kontikiki/LiftTruck_IoT/schematic.png

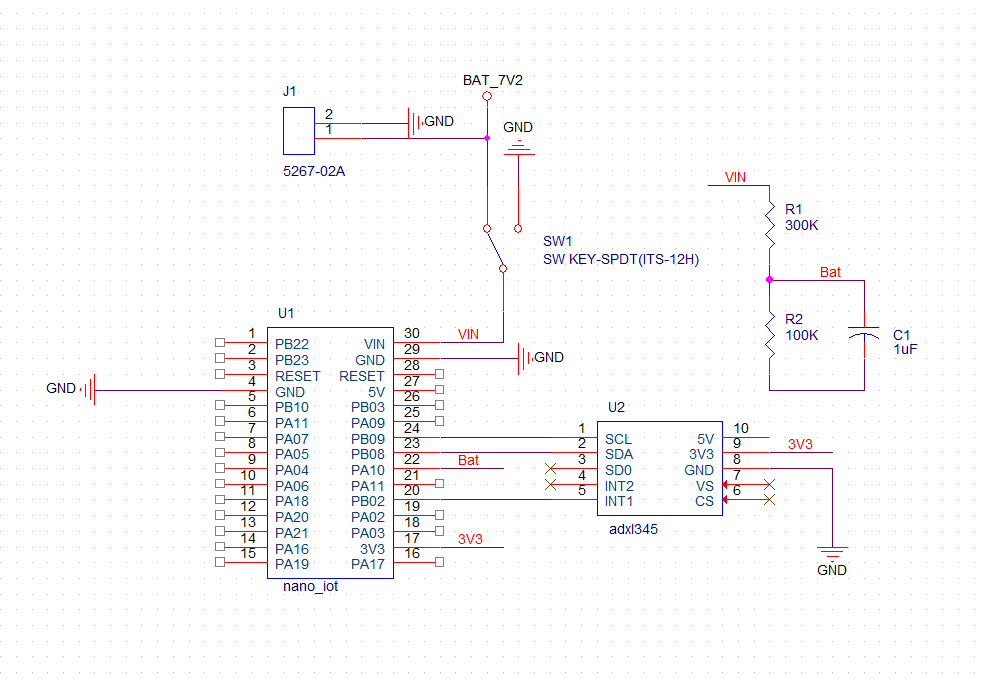
schematic.png
