kontikiki/LiftTruck_IoT/3d model/upper.stl

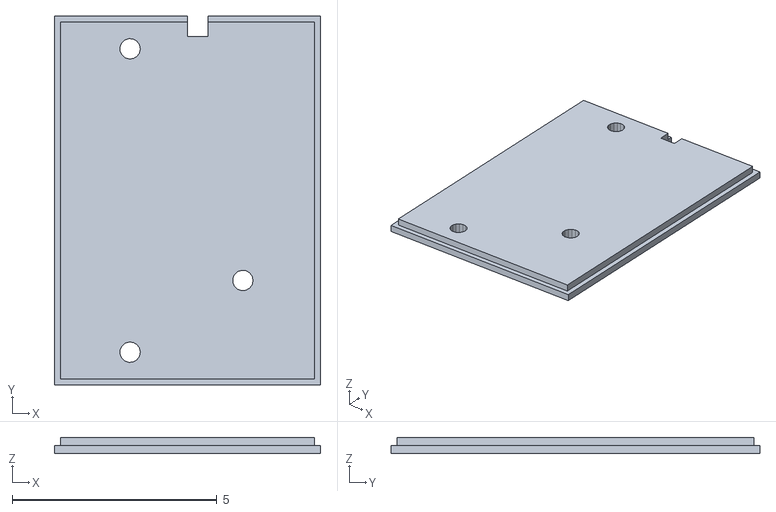
[picture p2: CAD file, 2020-04-03]
3d model/upper.stl
6.50 x 9.00 x 0.4
