kontikiki/LiftTruck_IoT/3d model/case.stl

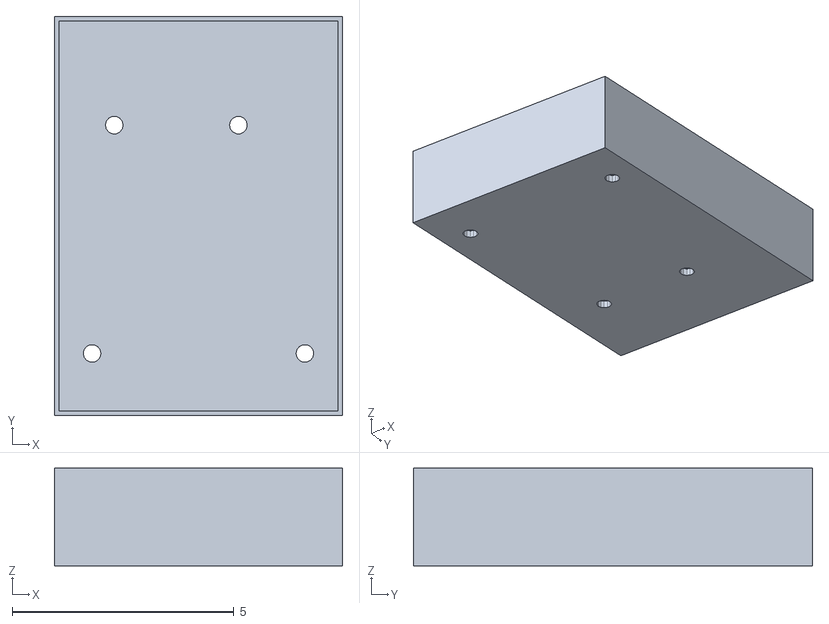
[picture p3: CAD file, 2020-04-03]
3d model/case.stl
6.50 x 9.00 x 2.20
