kontikiki/LiftTruck_IoT/(list of files, cad)

Other CAD files:
3d model/case.ipt
3d model/upper.ipt
