kontikiki/LiftTruck_IoT/rtc_adxl345_nano33_bleSerial_editEEPROM_aidsoft_v2/rtc_adxl345_nano33_bleSerial_editEEPROM_aidsoft_v2.ino

#include "WiFiNINA.h"
#include "WiFiUdp.h"
#include "Wire.h"
#include "ArduinoLowPower.h"
#include "SparkFun_ADXL345.h"
#include <math.h>
#include "FlashAsEEPROM_yn.h"
#include "AidSoft.h"
#include "secrets.h"
#include "ArduinoJson.h"

#define SERIAL_BAUDRATE 9600  //serial baud rate

#define SERVER_HOURS 00 //Server sending time(-debug-)
#define SERVER_MINUTES 15
#define SERVER_SECONDS 00

#define ALARM_TIMING 600000  //vehicle active mode measure-alarm timing(millis-debug-)

#define ACCEL_RANGE 4 //accelerometer range setting value
#define ACT_THRESHOLD 25  //accelerometer activity occur threshold
//accel data rate : 3200 ~ 0.098 our target rate is 100,50,25,12.5,6.25,3.125,1.563
#define ACCEL_RATE 100  //accelerometer data rate setting value
#define SAMPLING_NUM 10.0 // number of sampling
#define MEASURING_NUM 100 //measuring num per one sample
#define ACCEL_DELAY 10 //measurement sampling timing for 100 Hz
#define SPL_PERIOD    10  
#define SVM_BUFSIZE   (SPL_PERIOD*1) // buffer for calculation of accel avg sample
#define DEFINE_ACCEL 5.0  //active alarm mode condition

#define pin 15  //accel activity interrupt pin
#define BAT_PIN A3  //battery voltage measuring pin
#define VOLTAGE_FACTOR 4  //real value*4 = total battery value 
#define DEVICE_ID "A0003"

/*
   accelerometer
*/
// LSM6DS3Core myIMU(I2C_MODE,0x6B);
ADXL345 adxl = ADXL345();   //I2C
//ADXL345 adxl = ADXL345(3);  // SPI

typedef struct {
  float avg_acc;
  float acc_max;
} AccelData;

float base_accx, base_accy, base_accz;

void calibAccel();
void calculAccel(AccelData& accel);
float Calculate_std(float SVM_value);
void dataInit();
float SVM_buf[SVM_BUFSIZE];
float SVM_sum;
float SVM_avg; //The average value of STD values during the measurement time

//Buffer for calculating STD values
float STD_term[SVM_BUFSIZE];
float STD_term_sum;
float STD;
uint32_t spl_cnt;
uint32_t spl_time_cnt = 1;


/*
   Wifi connection & RTC
*/
char ssid[] = SECRET_SSID;
char pass[] = SECRET_PASS;
int keyIndex = 0;
WiFiClient client;
int status = WL_IDLE_STATUS;
unsigned long GMT = 9 * 60 * 60; //gap seconds between (seoul,South Korea) and GMT

void printWiFiStatus();
void resetEpoch();
void printEpoch();
void print2digits(int number);

/*
   Server
*/
const char * APIKey = SECRET_WRITE_APIKEY;

uint8_t number1 = 0;
uint8_t number2 = 0;
const char *number3 = DEVICE_ID;
String myStatus = ""; //for battery-state
String timeStamp = "";

void sendToServer(int number);
void sendVoltageStateToServer();
int readBattery();

/*
   for read & write data to flash
*/
char buf[128];

//instance for read & write packet to flash and number of written packet
EEPROMpacket EEPROMpkt;
EEPROMpacket writtenPacket[128];
int pkt_num;

void initFlash();
int readPacketFromFlash();
void writePacketToFlash();
//void packetMake(float acc_max, float avg_acc);
void packetMake(bool active);
void getHighActiveTime();

/*
   interrupt flag (time to sending data flag, accel activity occur flag, alarm mode(vehicle active-state) flag )
*/
volatile bool time_flag = false;  //24 o'clock RTC wake up interrupt flag (for sending data)
volatile bool accel_flag = false; //accelerometer activity-wake up interrupt flag
//volatile bool inact_flag = false;
volatile bool setActiveAlarm_flag = false;  //vehicle active-state flag


/***********************function definition ******************************/

/*
   for accelerometer calibration, calculation
*/
void dataInit()
{
  spl_cnt = 0;
  SVM_sum = 0;
  SVM_avg = 0;
  STD_term_sum = 0;

  for (int i = 0 ; i < SVM_BUFSIZE ; i++)
  {
    SVM_buf[i] = 0;
    STD_term[i] = 0;
  }
}

float Calculate_std(float SVM_value)
{
  float STD_value;

  SVM_sum = SVM_sum - SVM_buf[0];
  STD_term_sum = STD_term_sum - STD_term[0];

  /* data shift */
  for (int i = 1 ; i < SVM_BUFSIZE ; i++)
  {
    SVM_buf[i - 1] = SVM_buf[i];
    STD_term[i - 1] = STD_term[i];
  }
  SVM_buf[SVM_BUFSIZE - 1] = SVM_value;
  SVM_sum = SVM_sum + SVM_buf[SVM_BUFSIZE - 1];

  if (spl_cnt >= SVM_BUFSIZE) {
    SVM_avg = SVM_sum / SVM_BUFSIZE;
  } else {
    SVM_avg = SVM_sum / spl_cnt;
  }

  STD_term[SVM_BUFSIZE - 1] = pow((SVM_value - SVM_avg), 2.0);
  STD_term_sum = STD_term_sum + STD_term[SVM_BUFSIZE - 1];

  STD_value = (float)sqrt(STD_term_sum / SVM_BUFSIZE);

  return STD_value;
}

void calibAccel() {

  int x, y, z;
  int32_t sumAcX = 0, sumAcY = 0, sumAcZ = 0;
  adxl.setRate(ACCEL_RATE);
  delay(ACCEL_DELAY);
  for (int i = 0; i < 100; i++) {

    adxl.readAccel(&x, &y, &z);
    sumAcX += x;
    sumAcY += y;
    sumAcZ += z;
    digitalWrite(LED_BUILTIN, HIGH);
    delay(ACCEL_DELAY / 2);
    digitalWrite(LED_BUILTIN, LOW);
    delay(ACCEL_DELAY / 2);
  }

  base_accx = sumAcX / 10;
  base_accy = sumAcY / 10;
  base_accz = sumAcZ / 10;


  //  for debugging
  Serial.print("base_accx :");
  Serial.println(base_accx);
  Serial.print("base_accy :");
  Serial.println(base_accy);
  Serial.print("base_accz :");
  Serial.println(base_accz);
}

void calculAccel(AccelData& accel) {
 
  int x, y, z;
  float cal_x, cal_y, cal_z;

  float total_std = 0;
  float svm_acc = 0;
  float avg_std = 0;
  float std_max = 0;
  float temp_avg=0;
  float total_temp=0;
  
  for (int i = 0; i < SAMPLING_NUM ; i++) {
    dataInit();
    //100Hz sampling
    delay(ACCEL_DELAY);
    for (int i = 0; i < MEASURING_NUM; i++) {
      spl_cnt++;
      adxl.readAccel(&x, &y, &z);

      cal_x = (float)x - base_accx;
      cal_y = (float)y - base_accy;
      cal_z = (float)z - base_accz;

      svm_acc = sqrt(pow(cal_x, 2.0) + pow(cal_y, 2.0) + pow(cal_z, 2.0));
/*
      // Output Results to Serial
      Serial1.print(cal_x);
      Serial1.print(", ");
      Serial1.print(cal_y);
      Serial1.print(", ");
      Serial1.println(cal_z);
      Serial1.print("svm= ");
      Serial1.println(svm_acc);
*/
      STD = Calculate_std(svm_acc);

      if (STD > std_max) {
        std_max = STD;
      }
      total_std += STD;

      digitalWrite(LED_BUILTIN, HIGH);
      delay(ACCEL_DELAY / 2);
      digitalWrite(LED_BUILTIN, LOW);
      delay(ACCEL_DELAY / 2);
    }
    
    temp_avg=total_std /100;
    Serial.print("temp_avg_std=");
    Serial.println(temp_avg);
    total_temp+=temp_avg;
    total_std=0;
  }
    avg_std = total_temp / SAMPLING_NUM;

    Serial.println("------------------");
    Serial.print("avg_std =");
    Serial.println(avg_std);
    Serial.print("std_max=");
    Serial.println(std_max);
    Serial.println("------------------");
    accel.avg_acc = avg_std;
    accel.acc_max = std_max;
  }

  void sendVoltageStateToServer() {
    digitalWrite(LED_BUILTIN, HIGH);
    int x;
    int battery = readBattery();
    float voltage = ((float)map(battery, 0, 1024, 0, 33)) / 10.0;
    voltage=voltage*VOLTAGE_FACTOR;
    Serial.print(" battery voltage : ");
    Serial.println(voltage);
    sprintf(buf, "readValue : %d, battery voltage : %0.2f V", battery, voltage);
    myStatus = String(buf);

    connectServer();
    const int capacity = JSON_OBJECT_SIZE(2);
    StaticJsonDocument<capacity> JsonDoc;
    JsonDoc["status"] = myStatus.c_str();
    JsonDoc["field3"] = number3;
    int contentLength = measureJson(JsonDoc);
    serializeJson(JsonDoc, Serial);
    HTTPheader(contentLength, APIKey);
    serializeJson(JsonDoc, client);

    x = finishWrite();
    if (x == 200) {
      Serial.println("Channel update successful.");
    }
    else {
      Serial.print(" error code :");
      Serial.println(x);
      //  Serial1.println("Problem updating channel. HTTP error code ");
    }
    memset(buf, 0, sizeof(buf));
    delay(100);
    digitalWrite(LED_BUILTIN, LOW);
  }

  void sendToServer(int number) {
    int j, x, y;
    for (j = 0; j < number; j++) {
      digitalWrite(LED_BUILTIN, HIGH);
      //ex> "2017-01-12 13:22:54"
      sprintf(buf, "%d-%d-%d %d:%d:%d", 2000 + (writtenPacket[j].active_time.g_year), writtenPacket[j].active_time.g_month, writtenPacket[j].active_time.g_day, writtenPacket[j].active_time.g_hours, writtenPacket[j].active_time.g_minutes, writtenPacket[j].active_time.g_seconds);
      Serial.println(buf);
      timeStamp = String(buf);

      number1 = writtenPacket[j].active;
      number2 = writtenPacket[j].num;

      connectServer();
      const int capacity = JSON_OBJECT_SIZE(4);
      StaticJsonDocument<capacity> JsonDoc;
      JsonDoc["field1"] = number1;
      JsonDoc["field2"] = number2;
      JsonDoc["field3"] = number3;
      JsonDoc["created_at"] = timeStamp.c_str();
      int contentLength = measureJson(JsonDoc);
      serializeJson(JsonDoc, Serial);
      HTTPheader(contentLength, APIKey);
      serializeJson(JsonDoc, client);

      x = finishWrite();
      if (x == 200) {
        Serial.println("Channel update successful.");
      }
      else {
        Serial.print(" error code :");
        Serial.println(x);
        Serial.println("Problem updating channel. HTTP error code ");
      }
      Serial.println();
      memset(buf, 0, sizeof(buf));
      delay(100); //AidSoft update time gap
      digitalWrite(LED_BUILTIN, LOW);
    }
    Serial.println("all data are sent to AidSoft channel.");
  }

  //erase all written data in flash
  void initFlash() {
    EEPROM.isValid();
    EEPROM.commit();
    Serial.println("all data in flash was erased successly.");
    pkt_num = 0;
  }

  //read all written data from flash
  int readPacketFromFlash() {
    int i = 0;
    while (i < pkt_num) {
      writtenPacket[i] = EEPROM.read(i);

      Serial.print("read packet number: ");
      Serial.println(writtenPacket[i].num);
      sprintf(buf, "%d-%d-%d %d:%d:%d vehicle state :%d", 2000 + (writtenPacket[i].active_time.g_year), writtenPacket[i].active_time.g_month, writtenPacket[i].active_time.g_day, writtenPacket[i].active_time.g_hours, writtenPacket[i].active_time.g_minutes, writtenPacket[i].active_time.g_seconds, writtenPacket[i].active);
      Serial.println(buf);
      i++;
    }
    Serial.print(i);
    Serial.println(" packets in flash were Read Successly.");
    return i;
  }

  //write one data(acceleration & time) to flash
  void writePacketToFlash() {

    if (pkt_num > 127) {
      Serial.println("packet num is exceed range. restart 0-th packet.");
      pkt_num = 0;
    }
    EEPROM.convert(pkt_num, &EEPROMpkt);
    EEPROM.commit();
    Serial.println("Flash Writing Process Success.");
    pkt_num++;
  }

  //make data with packet time & accel data

  /*
    void packetMake(float acc_max, float avg_acc) {
    getHighActiveTime();
    Serial.println("------------------");
    EEPROMpkt.acc_max = acc_max;
    EEPROMpkt.avg_acc = avg_acc;
    EEPROMpkt.num = pkt_num;


    Serial.println("written packet data : ");
    Serial.println(EEPROMpkt.acc_max);
    Serial.println(EEPROMpkt.avg_acc);
    Serial.println(EEPROMpkt.num);
    Serial.println("============");
    Serial.println("Packet Make Success");
    }
  */
  void packetMake(bool active) {
    getHighActiveTime();
    Serial.println("------------------");
    EEPROMpkt.active = active;
    EEPROMpkt.num = pkt_num;
    Serial.println("written packet data : ");
    Serial.println(EEPROMpkt.active);
    Serial.println(EEPROMpkt.num);
    Serial.println("============");
    Serial.println("Packet Make Success");
  }

  //get present time
  void getHighActiveTime() {
    EEPROMpkt.active_time.g_day = (uint8_t)LowPower.rtc.getDay();
    EEPROMpkt.active_time.g_month = (uint8_t)LowPower.rtc.getMonth();
    EEPROMpkt.active_time.g_year = (uint8_t)LowPower.rtc.getYear();
    EEPROMpkt.active_time.g_hours = (uint8_t)LowPower.rtc.getHours();
    EEPROMpkt.active_time.g_minutes = (uint8_t)LowPower.rtc.getMinutes();
    EEPROMpkt.active_time.g_seconds = (uint8_t)LowPower.rtc.getSeconds();
    Serial.println("Timestamp Write Success");
  }

  int readBattery() {
    int readValue = analogRead(BAT_PIN);
    Serial.print("reading value is ");
    Serial.println(readValue);
    return readValue;
  }
  /*****************************setup()*********************************/
  void setup() {
    while (!Serial);
    Serial.begin(SERIAL_BAUDRATE);
    pinMode(pin, INPUT_PULLUP);
    pinMode(LED_BUILTIN, OUTPUT);
    pkt_num = 0;

    /*
      if (WiFi.status() == WL_NO_SHIELD) {
        Serial.println("WiFi shield not present");
        while (1);  //breakout
      }
    */
    while (status != WL_CONNECTED) {
      Serial.print("Attempting to connect to SSID: ");
      Serial.println(ssid);
      status = WiFi.begin(ssid, pass);
      delay(5000);
    }

    printWiFiStatus();

    LowPower.rtc.begin();

    resetEpoch(); //getting present time epoch

    WiFi.disconnect();
    WiFi.lowPowerMode();
    status = WL_IDLE_STATUS;

    LowPower.rtc.setAlarmTime(SERVER_HOURS,SERVER_MINUTES,SERVER_SECONDS);  //setting alarm time
    LowPower.rtc.enableAlarm(LowPower.rtc.MATCH_HHMMSS);
    LowPower.rtc.attachInterrupt(onTimeFlag);  //alarm interrupt wake up setting

    //accelerometer initial seqeunce timing value
    delayMicroseconds(1100);
    //accelerometer setting
    adxl.powerOn();
    //adxl.writeTo(ADXL345_POWER_CTL, 24);  //auto sleep mode, measure state
    //adxl.writeTo(0x2E,0x00); //enable DATA_READY Interrupt

    adxl.setRangeSetting(ACCEL_RANGE);  // range settings : Accepted values are 2g, 4g, 8g or 16g
    //  adxl.setRate(ACCEL_RATE);  // data rate setting : 1.563 Hz
    //adxl.setSpiBit(1);

    adxl.setActivityXYZ(1, 1, 1); // Set to activate movement detection in the axes "adxl.setActivityXYZ(X, Y, Z);" (1 == ON, 0 == OFF)
    adxl.setActivityThreshold(ACT_THRESHOLD);  // 62.5mg per increment   // Set activity   // activity thresholds (0-255)

    adxl.setInactivityXYZ(0, 0, 0);     // Set to detect inactivity in all the axes "adxl.setInactivityXYZ(X, Y, Z);" (1 == ON, 0 == OFF)

    adxl.setInactivityThreshold(75);    // 62.5mg per increment   // Set inactivity // Inactivity thresholds (0-255)
    adxl.setTimeInactivity(20);

    adxl.setTapDetectionOnXYZ(0, 0, 0);

    adxl.setInterruptLevelBit(1);   //set INT pin HIGH (active:low, non:high)
    //adxl.setInterruptMapping(ADXL345_INT_ACTIVITY_BIT, ADXL345_INT1_PIN);

    adxl.InactivityINT(0);
    adxl.ActivityINT(1);  //Turn on Interrupts for Activity mode(1 == ON, 0 == OFF)
    adxl.FreeFallINT(0);
    adxl.doubleTapINT(0);
    adxl.singleTapINT(0);

    calibAccel();
    delay(100);
    LowPower.attachInterruptWakeup(digitalPinToInterrupt(pin), onAccelFlag, FALLING);

    Serial.println("mcu is going to sleep.. ");
    Serial.println();

    delay(100);
      Serial.end();
    LowPower.sleep();
  }

  /**********************************loop()******************************/
  void loop() {
      Serial.begin(SERIAL_BAUDRATE);
      //while (!Serial);
    Serial.println("wake up!");

    //at 24 o'clock, sending data to server via AP
    if (time_flag) {
      Serial.println("onTime interrupt generated!");
      //    resetEpoch();
      time_flag = false;

    WiFi.noLowPowerMode();

    delay(500);
      while (status != WL_CONNECTED) {
      Serial.print("Attempting to connect to SSID: ");
      Serial.println(ssid);
      status = WiFi.begin(ssid, pass);
      delay(5000);
    }
  printWiFiStatus();
      sendVoltageStateToServer();
      if (pkt_num > 0) {
        int num = readPacketFromFlash();

        if (num == pkt_num) {
          Serial.println("all written packets were read from flash Successly.");
        }

        sendToServer(pkt_num);
        initFlash();
      }

    WiFi.disconnect();
    WiFi.lowPowerMode();
    status = WL_IDLE_STATUS;
    
      adxl.setActivityXYZ(1, 1, 1);
      adxl.ActivityINT(1);

      LowPower.attachInterruptWakeup(digitalPinToInterrupt(pin), onAccelFlag, FALLING);
    }

    //if activity interrupt signal occur from adxl345, accel_flag is true
    else if (accel_flag) {

      accel_flag = false;
      AccelData accel;
      calculAccel(accel);

      //Determine whether the average accel-value is higher or lower than the reference value,
      //if lower, go "just normal mode" : 24'o clock alarm setting and waiting for activity INT
      //if higher,go "active-alarm setting mode" : every 30 minutes wake-up setting, and estimate acceleration
      if (accel.avg_acc < DEFINE_ACCEL) {
        packetMake(0);
        writePacketToFlash();
     
        Serial.print(accel.avg_acc);
        Serial.print(" is < ");
        Serial.println(DEFINE_ACCEL);
        Serial.println("just normal mode.");

        LowPower.rtc.attachInterrupt(onTimeFlag);
        adxl.setActivityXYZ(1, 1, 1);
        adxl.ActivityINT(1);
        LowPower.attachInterruptWakeup(digitalPinToInterrupt(pin), onAccelFlag, FALLING);

      } else {
        packetMake(1);
        writePacketToFlash();
 
        Serial.print(accel.avg_acc);
        Serial.print(" is > ");
        Serial.println(DEFINE_ACCEL);
        Serial.print("Active ");
        Serial.print(ALARM_TIMING / 1000);
        Serial.println("sec alarm ON set");

        LowPower.rtc.disableAlarm();
        LowPower.setAlarmIn(ALARM_TIMING);
        LowPower.rtc.attachInterrupt(onHighFlag);
      }
    }//end of accel_flag

    //if vehicle is running mode, setActiveAlarm_flag is true
    else if (setActiveAlarm_flag) {

      setActiveAlarm_flag = false;

      AccelData accel;
      calculAccel(accel);

      if (accel.avg_acc > DEFINE_ACCEL) {
        packetMake(1);
        writePacketToFlash();

        Serial.print(accel.avg_acc);
        Serial.print(" is > ");
        Serial.println(DEFINE_ACCEL);
        Serial.print("and ");
        Serial.print(ALARM_TIMING / 1000);
        Serial.println("sec alarm is ON constantly.");

        LowPower.setAlarmIn(ALARM_TIMING);
        LowPower.rtc.attachInterrupt(onHighFlag);
      }
      else {
        packetMake(0);
        delay(100);
        writePacketToFlash();
        delay(100);

        Serial.print(accel.avg_acc);
        Serial.println(" is < ");
        Serial.println(DEFINE_ACCEL);
        Serial.println("Last written.");
        Serial.println("and alarm OFF set.");

        LowPower.rtc.detachInterrupt();
        LowPower.rtc.disableAlarm();
        LowPower.rtc.setAlarmTime(SERVER_HOURS,SERVER_MINUTES,SERVER_SECONDS);
        LowPower.rtc.enableAlarm(LowPower.rtc.MATCH_HHMMSS);

        delay(100);
        LowPower.rtc.attachInterrupt(onTimeFlag);
        adxl.setActivityXYZ(1, 1, 1);
        adxl.ActivityINT(1);
        LowPower.attachInterruptWakeup(digitalPinToInterrupt(pin), onAccelFlag, FALLING);
      }
    }//end of setActiveAlarm_flag
    Serial.println("mcu is going to sleep.. ");
    Serial.println();
    Serial.end();
    LowPower.sleep();
  }

  /************************Interrupt & Alarm ISR ****************************/

  void onHighFlag() {
    setActiveAlarm_flag = true;
  }

  void onTimeFlag() {
    time_flag = true;
    adxl.ActivityINT(0);
    adxl.setActivityXYZ(0, 0, 0);
    detachInterrupt(pin);
  }

  void onAccelFlag() {
    LowPower.rtc.detachInterrupt();
    adxl.ActivityINT(0);
    adxl.setActivityXYZ(0, 0, 0);
    detachInterrupt(pin);

    byte interrupts = adxl.getInterruptSource();
    if (adxl.triggered(interrupts, ADXL345_ACTIVITY)) {

      accel_flag = true;
    }
  }

  /************************ RTC getting WiFi epoch *************************/

  void resetEpoch() {
    unsigned long epoch;
    int numberOfTries = 0, maxTries = 10;
    do {
      epoch = WiFi.getTime();
      numberOfTries++;

      if (numberOfTries >= maxTries) {
        Serial.println("NTP unreachable!");
        numberOfTries = 0;
        delay(2000);
      }
    } while (epoch == 0);

    Serial.print("Epoch received : ");
    Serial.println(epoch);
    LowPower.rtc.setEpoch(epoch + GMT);
    //LowPower.rtc.setEpoch(epoch); //used in ThingSpeak
    printEpoch();
  }

  void print2digits(int number) {
    if (number < 10) {
      Serial.print("0"); // print a 0 before if the number is < than 10
    }
    Serial.print(number);
  }

  void printWiFiStatus() {
    Serial.print("SSID : ");
    Serial.println(WiFi.SSID());

    IPAddress ip = WiFi.localIP();
    Serial.print("IP Address : ");
    Serial.println(ip);

    long rssi = WiFi.RSSI();
    Serial.print("signal strength (RSSI) : ");
    Serial.print(rssi);
    Serial.println( "dBm");
  }

  void printEpoch() {
    Serial.println("-----------------");
    Serial.println("set WiFi RTC");
    print2digits(LowPower.rtc.getDay());
    Serial.print("/");
    print2digits(LowPower.rtc.getMonth());
    Serial.print("/");
    print2digits(LowPower.rtc.getYear());
    Serial.print(" ");
    // ...and time
    print2digits(LowPower.rtc.getHours());
    Serial.print(":");
    print2digits(LowPower.rtc.getMinutes());
    Serial.print(":");
    print2digits(LowPower.rtc.getSeconds());
    Serial.println();
  }
