kontikiki/LiftTruck_IoT/rtc_adxl345_nano33_20200309/rtc_adxl345_nano33_20200309.ino

#include <WiFiNINA.h>
#include <WiFiUdp.h>
//#include "SparkFunLSM6DS3.h"
#include "Wire.h"
#include <SPI.h>
//#include <time.h>
#include <ArduinoLowPower.h>
#include <SparkFun_ADXL345.h>
#include <math.h>
#include <FlashStorage.h>
#include <ThingSpeak.h>
#include "secrets.h"

#define DEFINE_ACCEL 20.0
int cnt=0;

char ssid[] = SECRET_SSID;
char pass[] = SECRET_PASS;
int keyIndex = 0;
WiFiClient client;

unsigned long myChannelNumber = SECRET_CH_ID;
const char * myWriteAPIKey = SECRET_WRITE_APIKEY;

// Initialize our values
float number1 = 0;
float number2 = 0;
int number3 = 0;

String myStatus = "";

int status = WL_IDLE_STATUS;

unsigned long GMT = 9 * 60 * 60; //gap seconds between (seoul,South Korea) and GMT
const int pin = 3;  //accelerometer activity-wake up interrupt generation pin

// LSM6DS3Core myIMU(I2C_MODE,0x6B);  //accelerometer
ADXL345 adxl = ADXL345();
//ADXL345 adxl = ADXL345(3);

volatile bool time_flag = false;  //24 o'clock RTC wake up interrupt flag (for sending data)
volatile bool accel_flag = false; //accelerometer activity-wake up interrupt flag
//volatile bool inact_flag = false;
volatile bool setActiveAlarm_flag = false;
char buf[64];

typedef struct timestamp {
  int g_day, g_month, g_year, g_hours, g_minutes, g_seconds;
}timestamp;

typedef struct EEPROMpacket {
  timestamp active_time;
  float svg_max;
  float avg_svg;
  int num;
}EEPROMpacket;

EEPROMpacket EEPROMpkt;
EEPROMpacket writtenPacket[48];
volatile int pkt_num;

Flash(accel_data_store, sizeof(EEPROMpacket));

float base_accx, base_accy, base_accz;

void sendThingSpeak(int number) {
  int j;
  for (j = 0; j < number; j++) {
    sprintf(buf, "%d/%d/%d/%d:%d:%d,max_svg: %f avg_svg: %f\n", writtenPacket[j].active_time.g_day, writtenPacket[j].active_time.g_month, writtenPacket[j].active_time.g_year, writtenPacket[j].active_time.g_hours, writtenPacket[j].active_time.g_minutes, writtenPacket[j].active_time.g_seconds, writtenPacket[j].svg_max, writtenPacket[j].avg_svg);
    Serial.println(buf);
    myStatus = String(buf);

    number1 = writtenPacket[j].svg_max;
    number2 = writtenPacket[j].avg_svg;
    number3 = writtenPacket[j].num;

    ThingSpeak.setField(1, number1);
    ThingSpeak.setField(2, number2);
    ThingSpeak.setField(3, number3);

    ThingSpeak.setStatus(myStatus);

    int x = ThingSpeak.writeFields(myChannelNumber, myWriteAPIKey);
    if (x == 200) {
      Serial.println("Channel update successful.");
    }
    else {
      Serial.println("Problem updating channel. HTTP error code " + String(x));
    }

    delay(20000);

  }
  Serial.println("all data are sent to thingSpeak channel.");
}

void initFlash() {
  int i;
  for (i = 0; i < pkt_num; i++) {
    accel_data_store.erase(i);
  }
  pkt_num = 0;
}

int readPacketFromFlash() {

  int i = 0;
  while (i < pkt_num) {
    accel_data_store.read(&(writtenPacket[i]),i);
    Serial.print("read packet number: ");
    Serial.println(writtenPacket[i].num);
    sprintf(buf, "%d/%d/%d/%d:%d:%d,max_svg: %f avg_svg: %f\n", writtenPacket[i].active_time.g_day, writtenPacket[i].active_time.g_month, writtenPacket[i].active_time.g_year, writtenPacket[i].active_time.g_hours, writtenPacket[i].active_time.g_minutes, writtenPacket[i].active_time.g_seconds, writtenPacket[i].svg_max, writtenPacket[i].avg_svg);
    Serial.println(buf);
    i++;
  }

  pkt_num=0;
  Serial.print(i);
  Serial.println(" packets in flash read Success.");

  return i;
}

void writePacketToFlash() {

  accel_data_store.write(&EEPROMpkt,pkt_num);

  Serial.println("Flash Writing Process Success.");

  pkt_num++;
}

void packetMake(float svg_max, float avg_svg) {
  getHighActiveTime();
  Serial.print("written packet time : ");
  Serial.println(EEPROMpkt.active_time.g_day);
  Serial.println(EEPROMpkt.active_time.g_month);
  Serial.println(EEPROMpkt.active_time.g_year);
  Serial.println(EEPROMpkt.active_time.g_hours);
  Serial.println(EEPROMpkt.active_time.g_minutes);
  Serial.println(EEPROMpkt.active_time.g_seconds);
  Serial.println("------------------");
  EEPROMpkt.svg_max = svg_max;
  EEPROMpkt.avg_svg = avg_svg;
  EEPROMpkt.num = pkt_num;

  
  Serial.print("written packet data : ");
  Serial.println(EEPROMpkt.svg_max);
  Serial.println(EEPROMpkt.avg_svg);
  Serial.println(EEPROMpkt.num);
  Serial.println("============");
  Serial.println("Packet Make Success");
}

void getHighActiveTime() {
  EEPROMpkt.active_time.g_day = rtc.getDay();
  EEPROMpkt.active_time.g_month = rtc.getMonth();
  EEPROMpkt.active_time.g_year = rtc.getYear();
  EEPROMpkt.active_time.g_hours = rtc.getHours();
  EEPROMpkt.active_time.g_minutes = rtc.getMinutes();
  EEPROMpkt.active_time.g_seconds = rtc.getSeconds();
  Serial.println("Timestamp Write Success");
}

void calibAccel() {
  int x, y, z;
  uint32_t sumAcX = 0, sumAcY = 0, sumAcZ = 0;

  for (int i = 0; i < 10; i++) {
    adxl.readAccel(&x, &y, &z);
    sumAcX += x;
    sumAcY += y;
    sumAcZ += z;
    delay(100);
  }

  base_accx = sumAcX / 10;
  base_accy = sumAcY / 10;
  base_accz = sumAcZ / 10;


  //  for debugging
  Serial.print("base_accx :");
  Serial.println(base_accx);
  Serial.print("base_accy :");
  Serial.println(base_accy);
  Serial.print("base_accz :");
  Serial.println(base_accz);

}

void setup() {
  while (!Serial);
  Serial.begin(115200);
  pinMode(pin, INPUT_PULLUP);
  pkt_num=0;

  /*
    if (WiFi.status() == WL_NO_SHIELD) {
      Serial.println("WiFi shield not present");
      while (1);  //breakout
    }
  */

  while (status != WL_CONNECTED) {
    Serial.print("Attempting to connect to SSID: ");
    Serial.println(ssid);

    status = WiFi.begin(ssid, pass);

    delay(10000);
  }

  printWiFiStatus();

  ThingSpeak.begin(client);

  rtc.begin();

  resetEpoch(); //getting present time epoch

  rtc.setAlarmMinutes(00);  //setting alarm time every day
  rtc.enableAlarm(rtc.MATCH_MMSS);
  rtc.attachInterrupt(onTimeFlag);  //alarm interrupt wake up setting

  //accelerometer setting
  adxl.powerOn();
  adxl.writeTo(ADXL345_POWER_CTL, 24);  //auto sleep mode, measure state

  adxl.setRangeSetting(2);  // range settings : Accepted values are 2g, 4g, 8g or 16g
  adxl.setRate(100);
  //adxl.setSpiBit(1);

  adxl.setActivityXYZ(0, 0, 1); // Set to activate movement detection in the axes "adxl.setActivityXYZ(X, Y, Z);" (1 == ON, 0 == OFF)
  adxl.setActivityThreshold(20);  // 62.5mg per increment   // Set activity   // activity thresholds (0-255)


  adxl.setInactivityXYZ(0, 0, 1);     // Set to detect inactivity in all the axes "adxl.setInactivityXYZ(X, Y, Z);" (1 == ON, 0 == OFF)

  adxl.setInactivityThreshold(20);    // 62.5mg per increment   // Set inactivity // Inactivity thresholds (0-255)
  adxl.setTimeInactivity(20);

  adxl.setTapDetectionOnXYZ(0, 0, 0);

  adxl.setInterruptLevelBit(0);
  //adxl.setInterruptMapping(ADXL345_INT_ACTIVITY_BIT, ADXL345_INT1_PIN);

  adxl.InactivityINT(0);
  adxl.ActivityINT(1);  //Turn on Interrupts for Activity mode(1 == ON, 0 == OFF)
  adxl.FreeFallINT(0);
  adxl.doubleTapINT(0);
  adxl.singleTapINT(0);

  /*
    bool autoSleep_check=adxl.getRegisterBit(ADXL345_POWER_CTL,4);
    if(autoSleep_check){
    Serial.println("adxl345 auto- sleep is on");
    }else{
      Serial.println("adxl345 auto- sleep is off");
    }
  */

  LowPower.attachInterruptWakeup(pin, onAccelFlag, FALLING);
  delay(3000);
  Serial.println("mcu is going to sleep.. ");
  Serial.println();
  Serial.end();
  LowPower.sleep();
}

void loop() {

  Serial.begin(115200);
  while (!Serial);
  Serial.println("wake up!! active-mode");
  /*
    bool autoSleep_check=adxl.getRegisterBit(ADXL345_POWER_CTL,4);
    if(autoSleep_check){
    Serial.println("adxl345 auto- sleep is on");
    }else{
    Serial.println("adxl345 auto- sleep is off");
    }
  */

  //at 24 o'clock, sending data to server via AP
  if (time_flag) {
    Serial.println("onTime interrupt generated!");
    resetEpoch();
    time_flag = false;

    int num = readPacketFromFlash();

    if (num == pkt_num) {
      Serial.println("all written packets are read from flash Successly.");
    }

    sendThingSpeak(pkt_num);

    initFlash();

    delay(500);

    adxl.ActivityINT(1);
    adxl.setActivityXYZ(0, 0, 1);

    attachInterrupt(pin, onAccelFlag, FALLING);

    /*
       data uploading to IoT Cloud

    */

    EExt_Interrupts in = g_APinDescription[pin].ulExtInt;
    EIC->WAKEUP.reg |= (1 << in);
  }

  else if (accel_flag) {

    calibAccel();

    int x, y, z;
    float cal_x = 0, cal_y = 0, cal_z = 0;

    uint32_t total_svg = 0;
    float svg_acc = 0;
    float avg_svg = 0;
    float svg_max = 0;


    //100Hz sampling
    for (int i = 0; i < 1000; i++) {

      adxl.readAccel(&x, &y, &z);

      cal_x = x - base_accx;
      cal_y = y - base_accy;
      cal_z = z - base_accz;

      svg_acc = sqrt(pow(cal_x, 2.0) + pow(cal_y, 2.0) + pow(cal_z, 2.0));

      if (svg_acc > svg_max) {
        svg_max = svg_acc;
      }

      total_svg += svg_acc;

      // Output Results to Serial
      /*
            Serial.print(cal_x);
            Serial.print(", ");
            Serial.print(cal_y);
            Serial.print(", ");
            Serial.println(cal_z);

            Serial.print("svg= ");
            Serial.println(svg_acc);
      */
      delay(10);
    }

    avg_svg = total_svg / 1000.0;


    Serial.println("------------------");
    Serial.print("avg_svg =");
    Serial.println(avg_svg);
    Serial.print("svg_max=");
    Serial.println(svg_max);
    Serial.println("------------------");


    /*EEPROM WRITE */
    accel_flag = false;

    if (avg_svg < DEFINE_ACCEL) {
      Serial.print(avg_svg);
      Serial.println(" is < 20.0");
      Serial.println("just normal mode.");
      rtc.attachInterrupt(onTimeFlag);

      delay(500);

      adxl.ActivityINT(1);
      adxl.setActivityXYZ(0, 0, 1);


  //    pinMode(pin, INPUT_PULLUP);

      attachInterrupt(pin, onAccelFlag, FALLING);

      EExt_Interrupts in = g_APinDescription[pin].ulExtInt;
      EIC->WAKEUP.reg |= (1 << in);

    } else {
      packetMake(svg_max, avg_svg);
      writePacketToFlash();
      Serial.println("EEPROM Writing..");
      Serial.print(avg_svg);
      Serial.println(" is > 20.0");
      Serial.println("Active 30sec alarm ON set");

      rtc.disableAlarm();
      rtc.setAlarmSeconds(30);
      rtc.enableAlarm(rtc.MATCH_SS);
      rtc.attachInterrupt(onHighFlag);

    }
    svg_max = 0;
    total_svg = 0;
  }//end of accel_flag

  else if (setActiveAlarm_flag) {
    setActiveAlarm_flag = false;
    calibAccel();
    delay(500);

    int x, y, z;
    float cal_x = 0, cal_y = 0, cal_z = 0;

    uint32_t total_svg = 0;
    float svg_max = 0;
    float svg_acc = 0;
    float avg_svg = 0;


    //100Hz sampling
    for (int i = 0; i < 1000; i++) {

      adxl.readAccel(&x, &y, &z);

      cal_x = x - base_accx;
      cal_y = y - base_accy;
      cal_z = z - base_accz;

      svg_acc = sqrt(pow(cal_x, 2.0) + pow(cal_y, 2.0) + pow(cal_z, 2.0));

      if (svg_acc > svg_max) {
        svg_max = svg_acc;
      }

      total_svg += svg_acc;

      // Output Results to Serial
      /*
            Serial.print(cal_x);
            Serial.print(", ");
            Serial.print(cal_y);
            Serial.print(", ");
            Serial.println(cal_z);

            Serial.print("svg= ");
            Serial.println(svg_acc);
      */
      delay(8);
    }

    avg_svg = total_svg / 1000.0;

    Serial.println("------------------");
    Serial.print("avg_svg =");
    Serial.println(avg_svg);
    Serial.print("svg_max=");
    Serial.println(svg_max);
    Serial.println("------------------");

    /*
        EEPROM Write
    */
    packetMake(svg_max, avg_svg);
    writePacketToFlash();
    Serial.println("EEPROM Writing..");
    if (avg_svg > DEFINE_ACCEL) {

      Serial.print(avg_svg);
      Serial.println(" is > 20.0");
      Serial.println("and 30 sec alarm is ON constantly.");
    }
    else {

      Serial.print(avg_svg);
      Serial.println(" is < 20.0");
      Serial.println("Last written.");
      Serial.println("and alarm OFF set.");

      rtc.detachInterrupt();
      rtc.disableAlarm();
      rtc.setAlarmMinutes(50);
      rtc.enableAlarm(rtc.MATCH_MMSS);
      rtc.attachInterrupt(onTimeFlag);

      adxl.ActivityINT(1);
      adxl.setActivityXYZ(0, 0, 1);
  //     pinMode(pin, INPUT_PULLUP);
      attachInterrupt(pin, onAccelFlag, FALLING);

      EExt_Interrupts in = g_APinDescription[pin].ulExtInt;
      EIC->WAKEUP.reg |= (1 << in);

    }
    total_svg = 0;
    svg_max = 0;
  }
  cnt++;
  Serial.println("mcu is going to sleep.. ");
  Serial.println();
  Serial.end();
  LowPower.sleep();

}

void onHighFlag() {
//  pinMode(pin, OUTPUT);
  delay(500);
 //  detachInterrupt(pin);
  setActiveAlarm_flag = true;
}

void onTimeFlag() {
  time_flag = true;
  adxl.ActivityINT(0);
  adxl.setActivityXYZ(0, 0, 0);
//  pinMode(pin, OUTPUT);
  delay(500);
  detachInterrupt(pin);
  
}

void onAccelFlag() {

//  pinMode(pin, OUTPUT);
  delay(500);
  detachInterrupt(pin);

  rtc.detachInterrupt();

  adxl.ActivityINT(0);
  adxl.setActivityXYZ(0, 0, 0);
  byte interrupts = adxl.getInterruptSource();
  if (adxl.triggered(interrupts, ADXL345_ACTIVITY)) {

    accel_flag = true;
  }
}

void resetEpoch() {
  unsigned long epoch;
  int numberOfTries = 0, maxTries = 6;
  do {
    epoch = WiFi.getTime();
    numberOfTries++;
  } while ((epoch == 0) && (numberOfTries < maxTries));

  if (numberOfTries == maxTries) {
    Serial.print("NTP unreachable!");
  } else {
    Serial.print("Epoch received : ");
    Serial.println(epoch);
    rtc.setEpoch(epoch + GMT);

    printEpoch();
  }
}

void print2digits(int number) {
  if (number < 10) {
    Serial.print("0"); // print a 0 before if the number is < than 10
  }
  Serial.print(number);
}

void printWiFiStatus() {
  Serial.print("SSID : ");
  Serial.println(WiFi.SSID());

  IPAddress ip = WiFi.localIP();
  Serial.print("IP Address : ");
  Serial.println(ip);

  long rssi = WiFi.RSSI();
  Serial.print("signal strength (RSSI) : ");
  Serial.print(rssi);
  Serial.println( "dBm");
}

void printEpoch() {
  Serial.println("-----------------");
  Serial.println("set WiFi RTC");
  print2digits(rtc.getDay());
  Serial.print("/");
  print2digits(rtc.getMonth());
  Serial.print("/");
  print2digits(rtc.getYear());
  Serial.print(" ");

  // ...and time
  print2digits(rtc.getHours());
  Serial.print(":");
  print2digits(rtc.getMinutes());
  Serial.print(":");
  print2digits(rtc.getSeconds());
  Serial.println();
}
