kontikiki/LiftTruck_IoT/rtc_adxl345_nano33_bleSerial_editEEPROM_aidsoft_v2/secrets.h

// Use this file to store all of the private credentials 
// and connection details

#define SECRET_SSID "olleh_WiFi_CF1D"		// replace MySSID with your WiFi network name
#define SECRET_PASS "0000009981"	// replace MyPassword with your WiFi password

#define SECRET_WRITE_APIKEY "88BCDBBD8D36F218CDA5D552B31CC4"   // replace XYZ with your channel write API Key
