kontikiki/LiftTruck_IoT/rtc_adxl345_nano33_btSerial_acc_value/secrets.h

// Use this file to store all of the private credentials 
// and connection details

#define SECRET_SSID "SSID"		// replace MySSID with your WiFi network name
#define SECRET_PASS "PASSWORD"	// replace MyPassword with your WiFi password

#define SECRET_CH_ID 1033834			// replace 0000000 with your channel number
#define SECRET_WRITE_APIKEY "RETTFLC07106EBIP"   // replace XYZ with your channel write API Key
