kontikiki/LiftTruck_IoT/rtc_adxl345_nano33_pre_version/rtc_adxl345_nano33_20200314/secrets.h

// Use this file to store all of the private credentials 
// and connection details

<<<<<<< HEAD
#define SECRET_SSID "damoatech"		// replace MySSID with your WiFi network name
#define SECRET_PASS "damoa007!"	// replace MyPassword with your WiFi password
=======
#define SECRET_SSID "SSID"		// replace MySSID with your WiFi network name
#define SECRET_PASS "PASSWORD"	// replace MyPassword with your WiFi password
>>>>>>> 79d336a0c32166ef516da1b65f810acb082edf3b

#define SECRET_CH_ID 1013182			// replace 0000000 with your channel number
#define SECRET_WRITE_APIKEY "HR76N7LOVHS5TCE3"   // replace XYZ with your channel write API Key
