kontikiki/LiftTruck_IoT/(commit log)

2020-03-20 add ArduinoLowPower library
2020-03-21 replace EIC WAKEUP.reg setting ->attachInterruptWakeup()
    [rtc_adxl345_nano33_20200321.ino]
2020-03-24 resizing buf[128] and add loop for ThingSpeak update trial, getting present epoch via NTP trial, and SystemReset(when NTP connection is failed)
    [rtc_adxl345_nano33_20200324.ino, secrets.h]
2020-03-25 fix calibration : uint32_t sumAcX; ->int32_t sumAcX;
    [SparkFun_ADXL345_Activity_INT_20200320.ino, rtc_adxl345_nano33_20200326.ino, secrets.h]
2020-03-27 fix calibration
2020-03-31 add PIn A3 reading Battery Voltage
2020-04-03 change UART: Serial1 for bluetooth SPP
    [case.ipt, case.stl, upper.ipt, upper.stl]
2020-04-03 add 3D modeling file & zumo control code
    [case.ipt, case.stl, upper.ipt, upper.stl]
2020-04-26 add Device_ID
2020-04-29 fix getting accel code, and json request code
    [rtc_adxl345_nano33_btSerial_editEEPROM_aidsoft_v2.ino]
